Crrismo/Espresso-Flow-Rate-embedded-programming/README.md

# Espresso-Flow-Rate-embedded-programming
